khcodxyz/Verdia-agrovision/VerdIA-AgroVision/docs/LEEME.txt

Poner aqui: BOM (PDF), FSM, esquema electronico, fotos del panel, resultados de burn-in y autonomia.
