khcodxyz/Verdia-agrovision/VerdIA-AgroVision/hardware/plancha_mdf_60x50.dxf

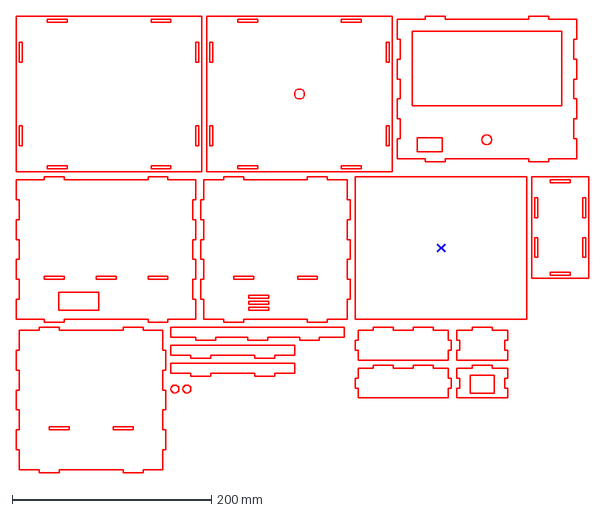
[picture p1: CAD file, 2026-11-07]
VerdIA-AgroVision/hardware/plancha_mdf_60x50.dxf
574.0 x 458.0 mm
